PabloDMM/LC_LightCanvas/02_Elements/LC_LightCanvas_Rev_2/00_Documents/3DElements/nodemcu-32s-1.snapshot.2/NodeMCU-32S Render.PNG

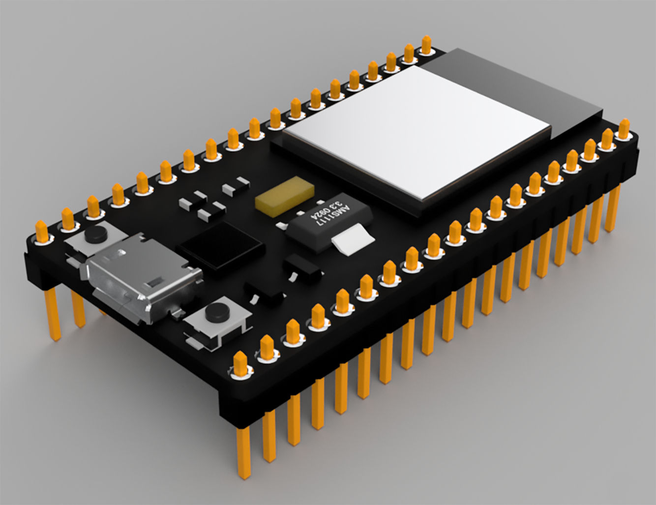
02_Elements/LC_LightCanvas_Rev_2/00_Documents/3DElements/nodemcu-32s-1.snapshot.2/NodeMCU-32S Render.PNG
