PabloDMM/LC_LightCanvas/02_Elements/LC_LightCanvas_Rev_2/00_Documents/LC_LightCanvas_MainConnection.jpg

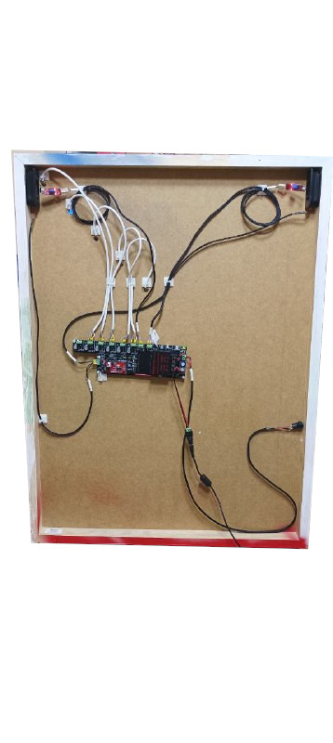
02_Elements/LC_LightCanvas_Rev_2/00_Documents/LC_LightCanvas_MainConnection.jpg
