PabloDMM/LC_LightCanvas/02_Elements/LC_LightCanvas_Rev_2/00_Documents/LC_LightCanvas_Rev_2_3DRender_TOP.png

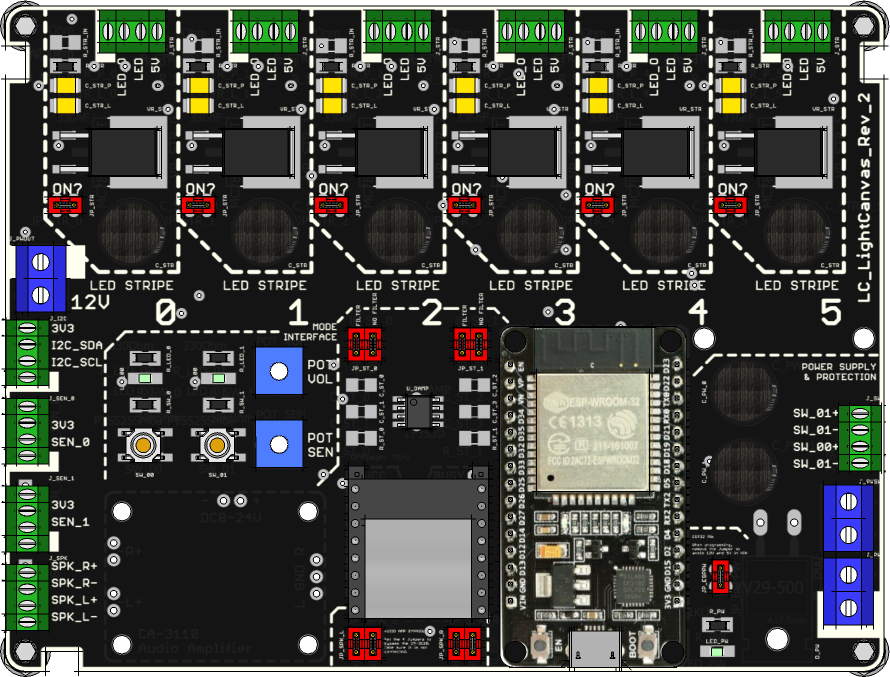
02_Elements/LC_LightCanvas_Rev_2/00_Documents/LC_LightCanvas_Rev_2_3DRender_TOP.png
