PabloDMM/LC_LightCanvas/02_Elements/LC_LightCanvas_Rev_2/01_HW/eagleUp/eagleUp_LC_LightCanvas_Rev_2_board_bottom.png

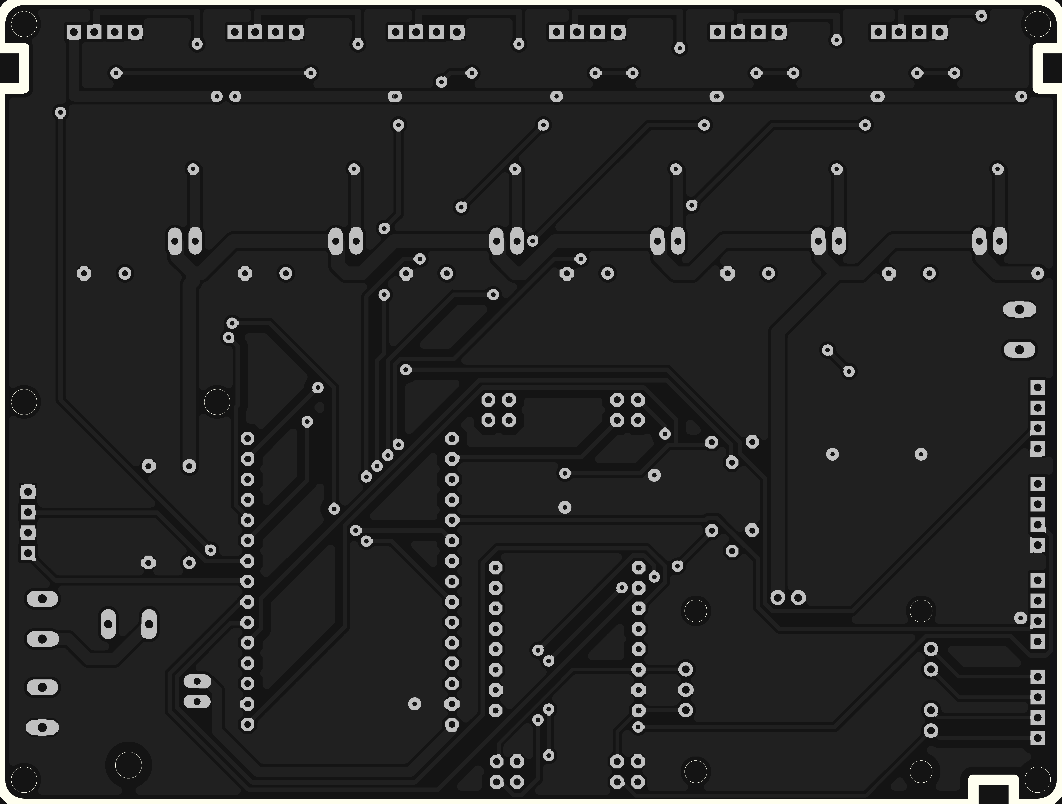
02_Elements/LC_LightCanvas_Rev_2/01_HW/eagleUp/eagleUp_LC_LightCanvas_Rev_2_board_bottom.png
