PabloDMM/LC_LightCanvas/02_Elements/LC_LightCanvas_Rev_2/00_Documents/3DElements/nodemcu-32s-1.snapshot.2/NodeMCU-32S.step

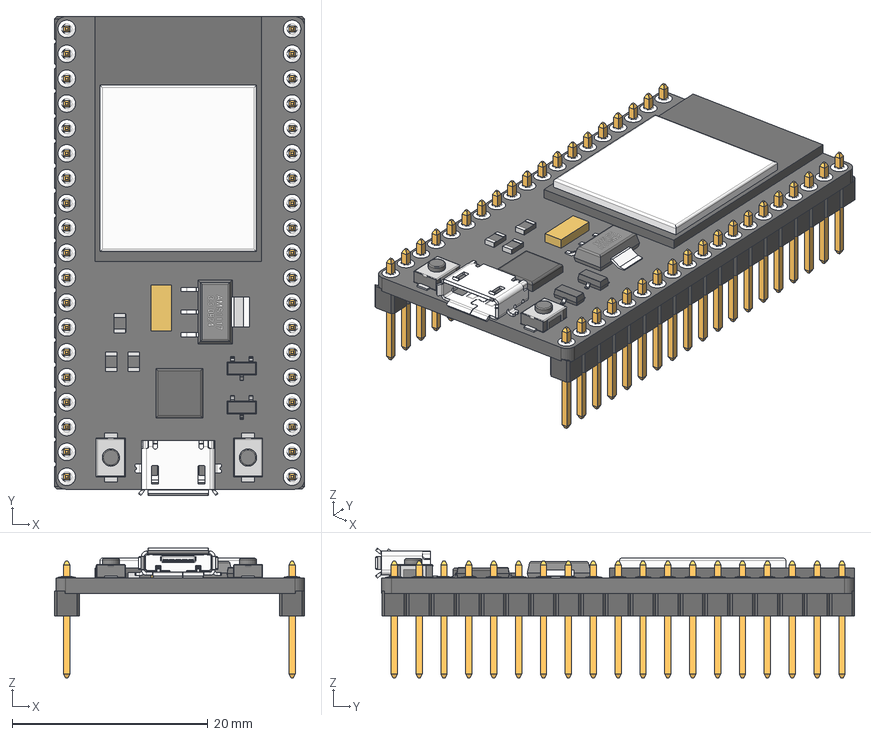
[picture p12: CAD file, 2022-08-26]
02_Elements/LC_LightCanvas_Rev_2/00_Documents/3DElements/nodemcu-32s-1.snapshot.2/NodeMCU-32S.step
25.5 x 48.9 x 13.3 mm
10104111-0001LF v1
zl201-19_p2-54_l48-3_w2-54_h8-9 v1 x 2
res_0805 v1 x 3
res_1206
AMS1117 v1
SOT23SMD v1 x 2
3x4x2mm - 2 Pad v1 x 2
