PabloDMM/LC_LightCanvas/(list of files, cad)

Other CAD files:
02_Elements/LC_LightCanvas_Rev_1/00_Documents/3DElements/0805.skp
02_Elements/LC_LightCanvas_Rev_1/00_Documents/3DElements/C0805.skp
02_Elements/LC_LightCanvas_Rev_1/00_Documents/3DElements/CHIPLED_0805.skp
02_Elements/LC_LightCanvas_Rev_1/00_Documents/3DElements/ESP32+WiFi+phone+esp32.skp
02_Elements/LC_LightCanvas_Rev_1/00_Documents/3DElements/ESP32-WROOM-32.skp
02_Elements/LC_LightCanvas_Rev_1/00_Documents/3DElements/FOS+-+Screw.skp
02_Elements/LC_LightCanvas_Rev_1/00_Documents/3DElements/LDR+(1).skp
02_Elements/LC_LightCanvas_Rev_1/00_Documents/3DElements/SOIC08.skp
02_Elements/LC_LightCanvas_Rev_1/00_Documents/3DElements/SOT-223.skp
02_Elements/LC_LightCanvas_Rev_1/00_Documents/3DElements/SOT-23-OT-5-LEAD.skp
02_Elements/LC_LightCanvas_Rev_1/00_Documents/3DElements/SOT23.skp
02_Elements/LC_LightCanvas_Rev_1/00_Documents/3DElements/Samtec+ESQ-116-12-G-S.skp
02_Elements/LC_LightCanvas_Rev_1/00_Documents/3DElements/Untitled.skp
02_Elements/LC_LightCanvas_Rev_1/00_Documents/3DElements/esp-32.skp
02_Elements/LC_LightCanvas_Rev_1/00_Documents/3DElements/mini_tactile.skp
02_Elements/LC_LightCanvas_Rev_2/00_Documents/3DElements/0805.skp
02_Elements/LC_LightCanvas_Rev_2/00_Documents/3DElements/C0805.skp
02_Elements/LC_LightCanvas_Rev_2/00_Documents/3DElements/CHIPLED_0805.skp
02_Elements/LC_LightCanvas_Rev_2/00_Documents/3DElements/ESP32+WiFi+phone+esp32.skp
02_Elements/LC_LightCanvas_Rev_2/00_Documents/3DElements/ESP32-WROOM-32.skp
02_Elements/LC_LightCanvas_Rev_2/00_Documents/3DElements/FOS+-+Screw.skp
02_Elements/LC_LightCanvas_Rev_2/00_Documents/3DElements/LDR+(1).skp
02_Elements/LC_LightCanvas_Rev_2/00_Documents/3DElements/SOIC08.skp
02_Elements/LC_LightCanvas_Rev_2/00_Documents/3DElements/SOT-223.skp
02_Elements/LC_LightCanvas_Rev_2/00_Documents/3DElements/SOT-23-OT-5-LEAD.skp
02_Elements/LC_LightCanvas_Rev_2/00_Documents/3DElements/SOT23.skp
02_Elements/LC_LightCanvas_Rev_2/00_Documents/3DElements/Samtec+ESQ-116-12-G-S.skp
02_Elements/LC_LightCanvas_Rev_2/00_Documents/3DElements/Untitled.skp
02_Elements/LC_LightCanvas_Rev_2/00_Documents/3DElements/esp-32.skp
02_Elements/LC_LightCanvas_Rev_2/00_Documents/3DElements/mini_tactile.skp
02_Elements/LC_LightCanvas_Rev_2/00_Documents/LC_LightCanvas_Rev_2_3DRender.skp
