PabloDMM/LC_LightCanvas/02_Elements/LC_LightCanvas_Rev_1/01_HW/LC_LightCanvas_Rev_1.brd

## EAGLE design 02_Elements/LC_LightCanvas_Rev_1/01_HW/LC_LightCanvas_Rev_1.brd (2022-08-26, an earlier design)

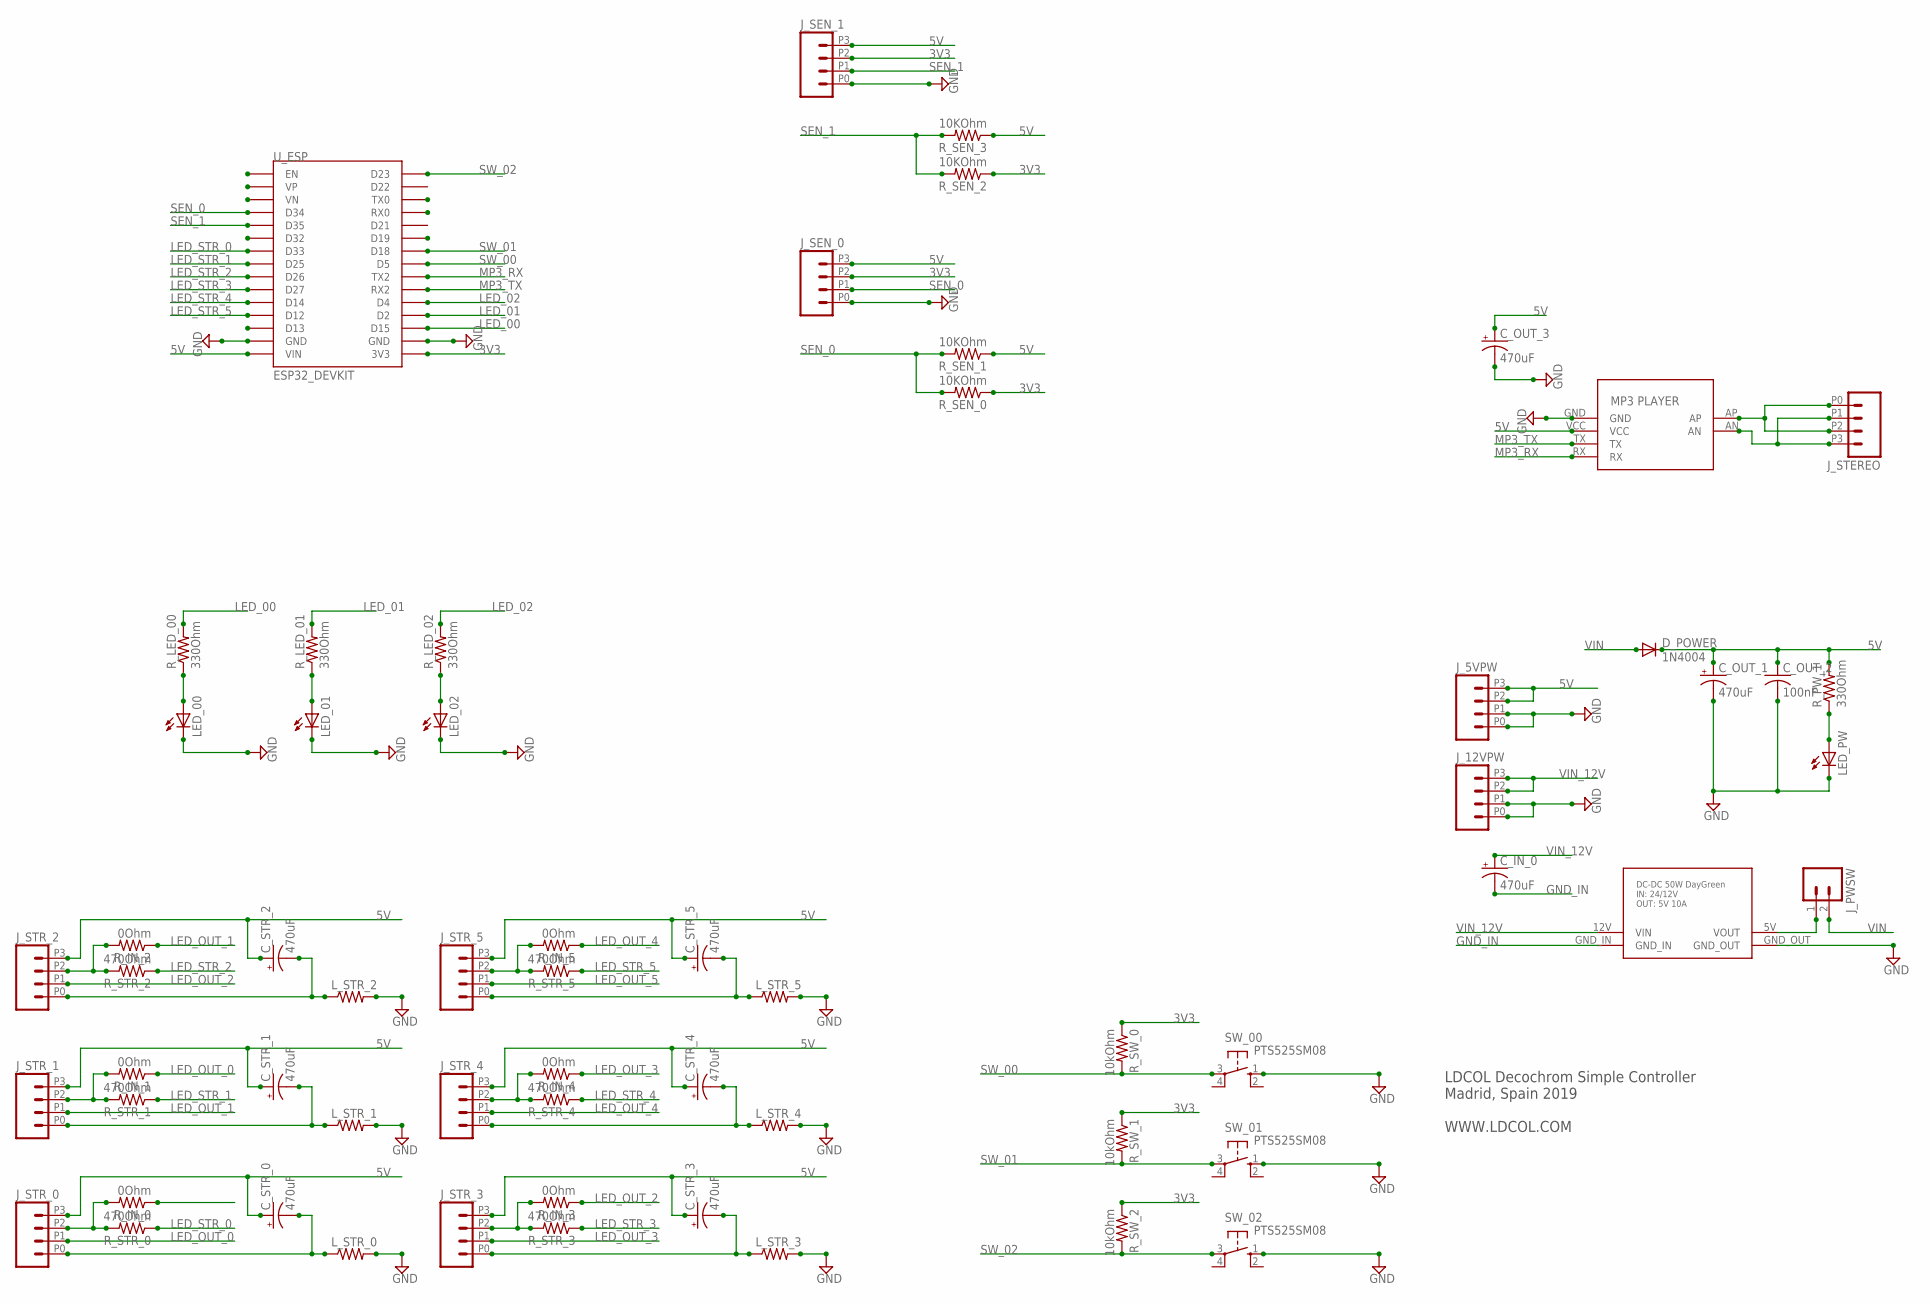
[picture p13: schematic LC_LightCanvas_Rev_1.sch]

Parts:
C_IN_0: 470uF; E5-10,5
C_OUT_1, C_OUT_3: 470uF; E5-10,5
C_OUT_2: 100nF; C0805
C_STR_0, C_STR_1, C_STR_2, C_STR_3, C_STR_4, C_STR_5: 470uF; E5-10,5
D_POWER: 1N4004; DO41-10
J_5VPW, J_12VPW: M04; 1X04_2.54_SCREWTERM
J_PWSW: M023.5MM-NO_SILK; SCREWTERMINAL-3.5MM-2-NS
J_SEN_0, J_SEN_1: M04; 1X04_2.54_SCREWTERM
J_STEREO: M04; 1X04_2.54_SCREWTERM
J_STR_0, J_STR_1, J_STR_2, J_STR_3, J_STR_4, J_STR_5: M04; 1X04_2.54_SCREWTERM
LED_00, LED_01, LED_02: LEDCHIPLED_0805; CHIPLED_0805
LED_PW: LEDCHIPLED_0805; CHIPLED_0805
L_STR_0, L_STR_1, L_STR_2, L_STR_3, L_STR_4, L_STR_5: R-US_R2012; R2012
R_IN_0, R_IN_1, R_IN_2, R_IN_3, R_IN_4, R_IN_5: 0Ohm; M0805
R_LED_00, R_LED_01, R_LED_02: 330Ohm; M0805
R_PW_1: 330Ohm; M0805
R_SEN_0, R_SEN_1, R_SEN_2, R_SEN_3: 10KOhm; M1206
R_STR_0, R_STR_1, R_STR_2, R_STR_3, R_STR_4, R_STR_5: 470Ohm; M0805
R_SW_0, R_SW_1, R_SW_2: 10kOhm; M0805
SW_00, SW_01, SW_02: PTS525SM08; SM08
U$1: DC_CONVERTER
U$2: MP3_PLAYER
U_ESP: ESP32_DEVKIT

Connections:
3V3: J_SEN_0.P2 (3), J_SEN_1.P2 (3), R_SEN_0.1, R_SEN_2.1, R_SW_0.1, R_SW_1.1, R_SW_2.1, U_ESP.3V3
5V: C_OUT_1.+, C_OUT_2.1, C_OUT_3.+, C_STR_0.+, C_STR_1.+, C_STR_2.+, C_STR_3.+, C_STR_4.+, C_STR_5.+, D_POWER.C, J_5VPW.P2 (3), J_5VPW.P3 (4), J_SEN_0.P3 (4), J_SEN_1.P3 (4), J_STR_0.P3 (4), J_STR_1.P3 (4), J_STR_2.P3 (4), J_STR_3.P3 (4), J_STR_4.P3 (4), J_STR_5.P3 (4), R_PW_1.2, R_SEN_1.1, R_SEN_3.1, U$2.VCC, U_ESP.VIN
GND: C_OUT_1.-, C_OUT_2.2, C_OUT_3.-, J_5VPW.P0 (1), J_5VPW.P1 (2), J_12VPW.P0 (1), J_12VPW.P1 (2), J_SEN_0.P0 (1), J_SEN_1.P0 (1), LED_00.C, LED_01.C, LED_02.C, LED_PW.C, L_STR_0.2, L_STR_1.2, L_STR_2.2, L_STR_3.2, L_STR_4.2, L_STR_5.2, SW_00.1 (S), SW_01.1 (S), SW_02.1 (S), U$1.GND_OUT, U$2.GND, U_ESP.GND@1 (GND), U_ESP.GND@2 (GND)
GND_IN: C_IN_0.-, U$1.GND_IN
LED_00: R_LED_00.2, U_ESP.D15
LED_01: R_LED_01.2, U_ESP.D2
LED_02: R_LED_02.2, U_ESP.D4
LED_OUT_0: J_STR_0.P1 (2), R_IN_1.1
LED_OUT_1: J_STR_1.P1 (2), R_IN_2.1
LED_OUT_2: J_STR_2.P1 (2), R_IN_3.1
LED_OUT_3: J_STR_3.P1 (2), R_IN_4.1
LED_OUT_4: J_STR_4.P1 (2), R_IN_5.1
LED_OUT_5: J_STR_5.P1 (2)
LED_STR_0: R_STR_0.1, U_ESP.D33
LED_STR_1: R_STR_1.1, U_ESP.D25
LED_STR_2: R_STR_2.1, U_ESP.D26
LED_STR_3: R_STR_3.1, U_ESP.D27
LED_STR_4: R_STR_4.1, U_ESP.D14
LED_STR_5: R_STR_5.1, U_ESP.D12
MP3_RX: U$2.RX, U_ESP.TX2
MP3_TX: U$2.TX, U_ESP.RX2
unnamed: LED_01.A, R_LED_01.1
unnamed: LED_02.A, R_LED_02.1
unnamed: C_STR_0.-, J_STR_0.P0 (1), L_STR_0.1
unnamed: C_STR_1.-, J_STR_1.P0 (1), L_STR_1.1
unnamed: J_STR_1.P2 (3), R_IN_1.2, R_STR_1.2
unnamed: LED_00.A, R_LED_00.1
unnamed: J_PWSW.1, U$1.5V (VOUT)
unnamed: LED_PW.A, R_PW_1.1
unnamed: J_STR_0.P2 (3), R_IN_0.2, R_STR_0.2
unnamed: C_STR_3.-, J_STR_3.P0 (1), L_STR_3.1
unnamed: C_STR_2.-, J_STR_2.P0 (1), L_STR_2.1
unnamed: J_STR_2.P2 (3), R_IN_2.2, R_STR_2.2
unnamed: J_STR_3.P2 (3), R_IN_3.2, R_STR_3.2
unnamed: C_STR_4.-, J_STR_4.P0 (1), L_STR_4.1
unnamed: J_STR_4.P2 (3), R_IN_4.2, R_STR_4.2
unnamed: C_STR_5.-, J_STR_5.P0 (1), L_STR_5.1
unnamed: J_STR_5.P2 (3), R_IN_5.2, R_STR_5.2
unnamed: J_STEREO.P0 (1), J_STEREO.P2 (3), U$2.AP
unnamed: J_STEREO.P1 (2), J_STEREO.P3 (4), U$2.AN
SEN_0: J_SEN_0.P1 (2), R_SEN_0.2, R_SEN_1.2, U_ESP.D34
SEN_1: J_SEN_1.P1 (2), R_SEN_2.2, R_SEN_3.2, U_ESP.D35
SW_00: R_SW_0.2, SW_00.3, U_ESP.D5
SW_01: R_SW_1.2, SW_01.3, U_ESP.D18
SW_02: R_SW_2.2, SW_02.3, U_ESP.D23
VIN: D_POWER.A, J_PWSW.2
VIN_12V: C_IN_0.+, J_12VPW.P2 (3), J_12VPW.P3 (4), U$1.12V (VIN)

Notes on the sheet:
LDCOL Decochrom Simple Controller Madrid, Spain 2019 WWW.LDCOL.COM

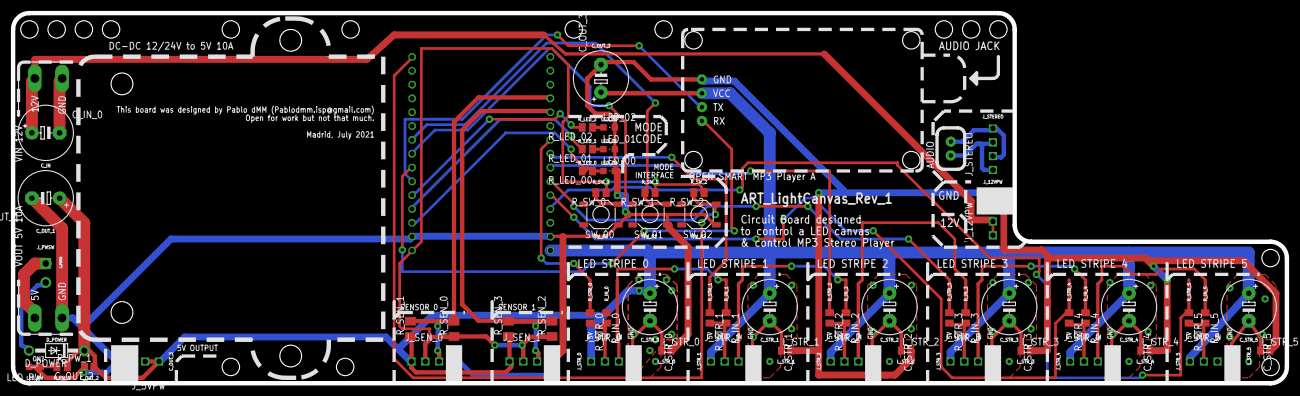
[picture p14: board LC_LightCanvas_Rev_1.brd from above]

Board: 2 copper layers, 234.0 x 68.0 mm, 62 parts (1 on the bottom side), 46 nets.
