PabloDMM/LC_LightCanvas/02_Elements/LC_LightCanvas_Rev_2/01_HW/LC_LightCanvas_Rev_2.sch

## EAGLE design 02_Elements/LC_LightCanvas_Rev_2/01_HW/LC_LightCanvas_Rev_2.sch (2022-08-26)

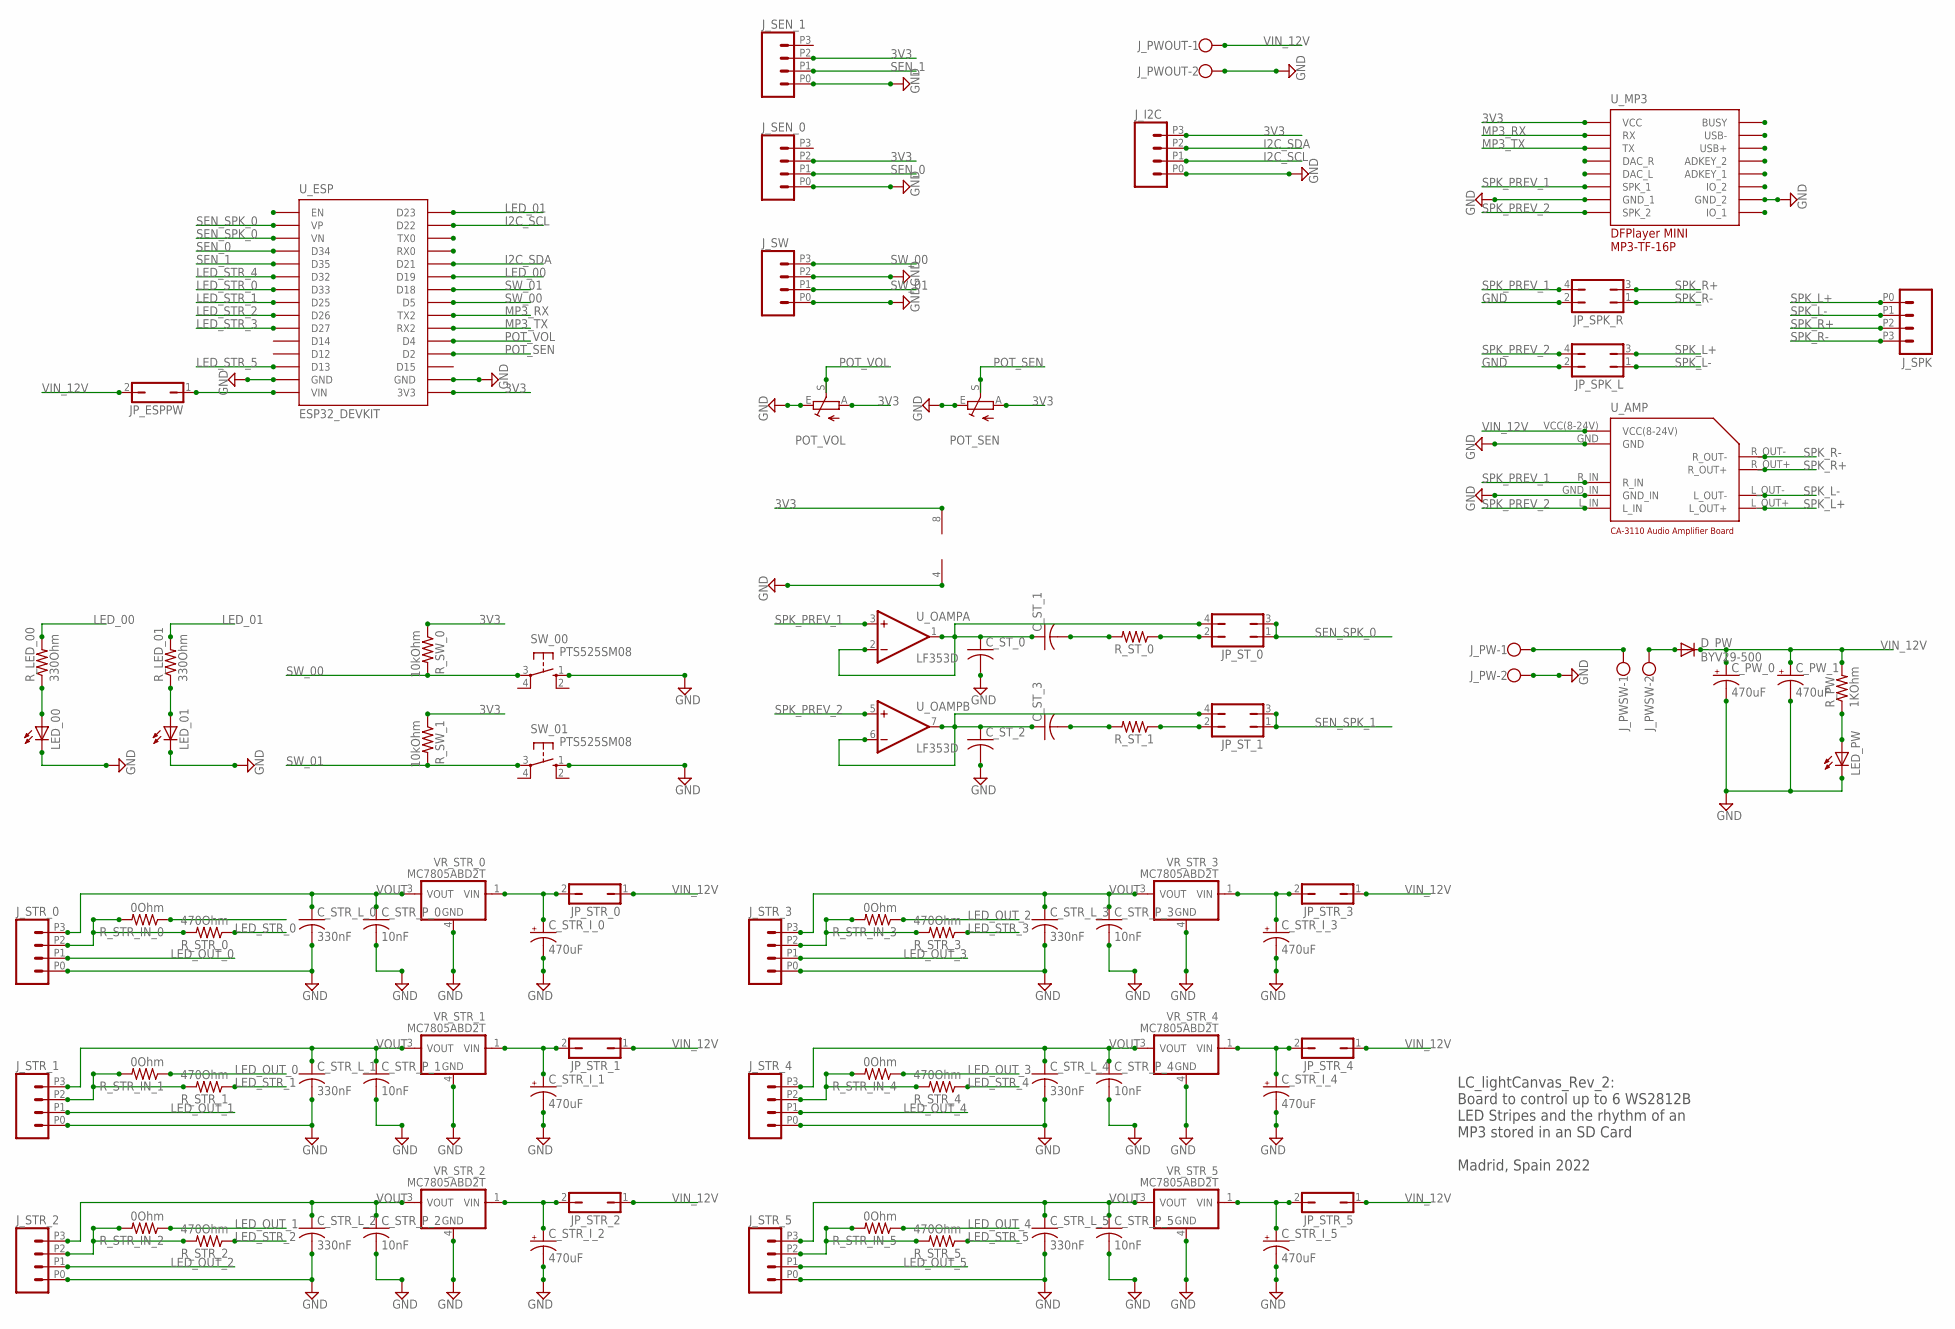
[picture p15: schematic LC_LightCanvas_Rev_2.sch]

Parts:
C_PW_0, C_PW_1: 470uF; TT5D10
C_STR_I_0, C_STR_I_1, C_STR_I_2, C_STR_I_3, C_STR_I_4, C_STR_I_5: 470uF; TT5D10
C_STR_L_0, C_STR_L_1, C_STR_L_2, C_STR_L_3, C_STR_L_4, C_STR_L_5: 330nF; C1206
C_STR_P_0, C_STR_P_1, C_STR_P_2, C_STR_P_3, C_STR_P_4, C_STR_P_5: 10nF; C1206
C_ST_0, C_ST_1, C_ST_2, C_ST_3: C-USC1206; C1206
D_PW: BYV29-500; TO220AC
JP_ESPPW: JP1Q; JP1
JP_SPK_L: JP2Q
JP_SPK_R: JP2Q
JP_STR_0, JP_STR_1, JP_STR_2, JP_STR_3, JP_STR_4, JP_STR_5: JP1Q; JP1
JP_ST_0, JP_ST_1: JP2Q
J_I2C: M04; 1X04_2.54_SCREWTERM
J_PW: W237-102
J_PWOUT: W237-102
J_PWSW: W237-102
J_SEN_0, J_SEN_1: M04; 1X04_2.54_SCREWTERM
J_SPK: M04; 1X04_2.54_SCREWTERM
J_STR_0, J_STR_1, J_STR_2, J_STR_3, J_STR_4, J_STR_5: M04; 1X04_2.54_SCREWTERM
J_SW: M04; 1X04_2.54_SCREWTERM
LED_00, LED_01: LEDCHIPLED_1206; CHIPLED_1206
LED_PW: LEDCHIPLED_1206; CHIPLED_1206
POT_SEN: TRIM_EU-CT6; CT6
POT_VOL: TRIM_EU-CT6; CT6
R_LED_00, R_LED_01: 330Ohm; M1206
R_PW: 1KOhm; M1206
R_STR_0, R_STR_1, R_STR_2, R_STR_3, R_STR_4, R_STR_5: 470Ohm; M1206
R_STR_IN_0, R_STR_IN_1, R_STR_IN_2, R_STR_IN_3, R_STR_IN_4, R_STR_IN_5: 0Ohm; M1206
R_ST_0, R_ST_1: R-US_M1206; M1206
R_SW_0, R_SW_1: 10kOhm; M1206
SW_00, SW_01: PTS525SM08; SM08
U_AMP: CA-3110_AUDIOAMPLIFIER
U_ESP: ESP32_DEVKIT
U_MP3: DFPLAYER
U_OAMP: LF353D; SO08
VR_STR_0, VR_STR_1, VR_STR_2, VR_STR_3, VR_STR_4, VR_STR_5: MC7805ABD2T; D2PAK-3

Connections:
3V3: J_I2C.P3 (4), J_SEN_0.P2 (3), J_SEN_1.P2 (3), POT_SEN.A, POT_VOL.A, R_SW_0.1, R_SW_1.1, U_ESP.3V3, U_MP3.VCC, U_OAMP.8 (V+)
GND: C_PW_0.-, C_PW_1.-, C_STR_I_0.-, C_STR_I_1.-, C_STR_I_2.-, C_STR_I_3.-, C_STR_I_4.-, C_STR_I_5.-, C_STR_L_0.2, C_STR_L_1.2, C_STR_L_2.2, C_STR_L_3.2, C_STR_L_4.2, C_STR_L_5.2, C_STR_P_0.2, C_STR_P_1.2, C_STR_P_2.2, C_STR_P_3.2, C_STR_P_4.2, C_STR_P_5.2, C_ST_0.2, C_ST_2.2, JP_SPK_L.2, JP_SPK_R.2, J_I2C.P0 (1), J_PW.2, J_PWOUT.2, J_SEN_0.P0 (1), J_SEN_1.P0 (1), J_STR_0.P0 (1), J_STR_1.P0 (1), J_STR_2.P0 (1), J_STR_3.P0 (1), J_STR_4.P0 (1), J_STR_5.P0 (1), J_SW.P0 (1), J_SW.P2 (3), LED_00.C, LED_01.C, LED_PW.C, POT_SEN.E, POT_VOL.E, SW_00.1 (S), SW_01.1 (S), U_AMP.GND, U_AMP.GND_IN, U_ESP.GND@1 (GND), U_ESP.GND@2 (GND), U_MP3.GND_1, U_MP3.GND_2, U_OAMP.4 (V-), VR_STR_0.4 (GND), VR_STR_1.4 (GND), VR_STR_2.4 (GND), VR_STR_3.4 (GND), VR_STR_4.4 (GND), VR_STR_5.4 (GND)
I2C_SCL: J_I2C.P1 (2), U_ESP.D22
I2C_SDA: J_I2C.P2 (3), U_ESP.D21
LED_00: R_LED_00.2, U_ESP.D19
LED_01: R_LED_01.2, U_ESP.D23
LED_OUT_0: J_STR_0.P1 (2), R_STR_IN_1.1
LED_OUT_1: J_STR_1.P1 (2), R_STR_IN_2.1
LED_OUT_2: J_STR_2.P1 (2), R_STR_IN_3.1
LED_OUT_3: J_STR_3.P1 (2), R_STR_IN_4.1
LED_OUT_4: J_STR_4.P1 (2), R_STR_IN_5.1
LED_OUT_5: J_STR_5.P1 (2)
LED_STR_0: R_STR_0.1, U_ESP.D33
LED_STR_1: R_STR_1.1, U_ESP.D25
LED_STR_2: R_STR_2.1, U_ESP.D26
LED_STR_3: R_STR_3.1, U_ESP.D27
LED_STR_4: R_STR_4.1, U_ESP.D32
LED_STR_5: R_STR_5.1, U_ESP.D13
MP3_RX: U_ESP.TX2, U_MP3.RX
MP3_TX: U_ESP.RX2, U_MP3.TX
unnamed: LED_01.A, R_LED_01.1
unnamed: J_STR_0.P2 (3), R_STR_0.2, R_STR_IN_0.2
unnamed: J_STR_1.P2 (3), R_STR_1.2, R_STR_IN_1.2
unnamed: LED_00.A, R_LED_00.1
unnamed: J_PW.1, J_PWSW.1
unnamed: LED_PW.A, R_PW.1
unnamed: JP_ESPPW.1, U_ESP.VIN
unnamed: J_STR_2.P2 (3), R_STR_2.2, R_STR_IN_2.2
unnamed: J_STR_3.P2 (3), R_STR_3.2, R_STR_IN_3.2
unnamed: C_ST_0.1, C_ST_1.1, JP_ST_0.4, U_OAMP.1 (OUT), U_OAMP.2 (-IN)
unnamed: C_ST_2.1, C_ST_3.1, JP_ST_1.4, U_OAMP.6 (-IN), U_OAMP.7 (OUT)
unnamed: J_STR_4.P2 (3), R_STR_4.2, R_STR_IN_4.2
unnamed: D_PW.A, J_PWSW.2
unnamed: C_ST_1.2, R_ST_0.2
unnamed: J_STR_5.P2 (3), R_STR_5.2, R_STR_IN_5.2
unnamed: JP_ST_0.2, R_ST_0.1
unnamed: C_ST_3.2, R_ST_1.2
unnamed: JP_ST_1.2, R_ST_1.1
POT_SEN: POT_SEN.S, U_ESP.D2
POT_VOL: POT_VOL.S, U_ESP.D4
SEN_0: J_SEN_0.P1 (2), U_ESP.D34
SEN_1: J_SEN_1.P1 (2), U_ESP.D35
SEN_SPK_0: JP_ST_0.1, JP_ST_0.3, U_ESP.VN, U_ESP.VP
SEN_SPK_1: JP_ST_1.1, JP_ST_1.3
SPK_L+: JP_SPK_L.3, J_SPK.P0 (1), U_AMP.L_OUT+
SPK_L-: JP_SPK_L.1, J_SPK.P1 (2), U_AMP.L_OUT-
SPK_PREV_1: JP_SPK_R.4, U_AMP.R_IN, U_MP3.SPK1 (SPK_1), U_OAMP.3 (+IN)
SPK_PREV_2: JP_SPK_L.4, U_AMP.L_IN, U_MP3.SPK2 (SPK_2), U_OAMP.5 (+IN)
SPK_R+: JP_SPK_R.3, J_SPK.P2 (3), U_AMP.R_OUT+
SPK_R-: JP_SPK_R.1, J_SPK.P3 (4), U_AMP.R_OUT-
SW_00: J_SW.P3 (4), R_SW_0.2, SW_00.3, U_ESP.D5
SW_01: J_SW.P1 (2), R_SW_1.2, SW_01.3, U_ESP.D18
VIN_12V: C_PW_0.+, C_PW_1.+, D_PW.C, JP_ESPPW.2, JP_STR_0.1, JP_STR_1.1, JP_STR_2.1, JP_STR_3.1, JP_STR_4.1, JP_STR_5.1, J_PWOUT.1, R_PW.2, U_AMP.VCC(8-24V)
VIN_POS: C_STR_I_0.+, JP_STR_0.2, VR_STR_0.1 (VIN)
VIN_POS1: C_STR_I_1.+, JP_STR_1.2, VR_STR_1.1 (VIN)
VIN_POS2: C_STR_I_2.+, JP_STR_2.2, VR_STR_2.1 (VIN)
VIN_POS3: C_STR_I_3.+, JP_STR_3.2, VR_STR_3.1 (VIN)
VIN_POS4: C_STR_I_4.+, JP_STR_4.2, VR_STR_4.1 (VIN)
VIN_POS5: C_STR_I_5.+, JP_STR_5.2, VR_STR_5.1 (VIN)
VOUT: C_STR_L_0.1, C_STR_L_1.1, C_STR_L_2.1, C_STR_L_3.1, C_STR_L_4.1, C_STR_L_5.1, C_STR_P_0.1, C_STR_P_1.1, C_STR_P_2.1, C_STR_P_3.1, C_STR_P_4.1, C_STR_P_5.1, J_STR_0.P3 (4), J_STR_1.P3 (4), J_STR_2.P3 (4), J_STR_3.P3 (4), J_STR_4.P3 (4), J_STR_5.P3 (4), VR_STR_0.3 (VOUT), VR_STR_1.3 (VOUT), VR_STR_2.3 (VOUT), VR_STR_3.3 (VOUT), VR_STR_4.3 (VOUT), VR_STR_5.3 (VOUT)

Notes on the sheet:
LC_lightCanvas_Rev_2: Board to control up to 6 WS2812B LED Stripes and the rhythm of an MP3 stored in an SD Card Madrid, Spain 2022
