PabloDMM/LC_LightCanvas/(commit log)

2022-08-26 First Commit
    - Inheritance from repository ART_Collage
    - First upload of LC_LightCanvas_Rev_2
    [0805.skp, C0805.skp, CHIPLED_0805.skp, ESP32+WiFi+phone+esp32.skp, ESP32-WROOM-32.skp, FOS+-+Screw.skp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]
2022-08-26 Fix of HW and Gerber Files
    Fixed HW
    Generation of Gerber Files
    Generation of 3D Model
    [LC_LightCanvas_Rev_2.GBL, LC_LightCanvas_Rev_2.GBO, LC_LightCanvas_Rev_2.GBP, LC_LightCanvas_Rev_2.GBS, LC_LightCanvas_Rev_2.GTL, LC_LightCanvas_Rev_2.GTO, LC_LightCanvas_Rev_2.GTP, LC_LightCanvas_Rev_2.GTS]
2022-10-29 Updated a new Image of the correction to H4_MainController_Rev_1 board
    [LC_LightCanvas_Rev_2_LedTest.ino]
