PabloDMM/LC_LightCanvas/(notices)

Notices in the files:
02_Elements/LC_LightCanvas_Rev_1/01_HW/LC_LightCanvas_Rev_1.sch:
CC BY-SA 2.0
parts and their libraries:
SparkFun-Connectors2: Licensing: Creative Commons ShareAlike 4.0 International - https://creativecommons.org/licenses/by-sa/4.0
